Elainezhang0510/Constellate-Braille-Display/hardware/enclosure/v3/使用说明.md

# 六执行器紧凑盒体（树莓派在盒外）

版本 v3（2026-10-16）：仅将两侧上方 39 × 2 mm 长窗缩短、缩窄为居中的 20 × 1.2 mm 散热缝。v2 的下方 39 × 4 mm 长窗、六个 8 mm 朝外套筒开口、盖子、孔位、外形、底板、承台、出线口和材料均保持不变。

全部模型以毫米建模。外形 40 × 56 × 37 mm，六执行器两列三行，中心距 16 mm；树莓派与驱动电路放盒外。

## 文件

- `container_assembly.step`：盒体和盖子的装配实体，可导入 Autodesk Fusion / Inventor。两个独立实体，不含执行器。
- `base.stl`：直接切片打印的盒体，底面已在 Z=0。
- `lid_print.stl`：直接切片打印的盖子，外表面朝下，凹槽朝上，已在 Z=0；此文件方向与装配 STEP 不同。
- `base.step`、`lid_print.step`：对应单件实体。
- `fit_coupon.stl`：省料试配件；左孔为 10.5 mm 壳体孔，右孔为 4.6 mm 头部孔。先打印这个，实物壳体和头部应能顺畅插入。
- `assembly_with_reference.step`：含六个简化执行器外形的检查模型。执行器外形只作参考，不能打印成执行器。
- `preview.png`：模型生成的装配与分解预览。
- `build_container.py`：可修改尺寸的 CadQuery 参数化源文件，需要 Python、cadquery、trimesh、matplotlib。
- `validation.json`：实体与网格检查结果。

Fusion 可直接打开或上传 STEP；导入 STL 时选择毫米。STEP 是可编辑实体，但不包含 Fusion 原生的参数历史。

## 结构与公差

普通壁、底、盖厚均为 2.4 mm。盖子有六个 4.6 mm 通孔（按用户要求兼容 4 mm 头部，直径余量 0.6 mm）；执行器定位孔仍为 10.5 mm（对应图片 10 mm 壳体，直径余量 0.5 mm）。本次加宽的是套筒侧面槽口，宽 8 mm、高 14 mm（Z=13–27 mm），不是扩大执行器定位孔。两列分别朝向最近的外侧长边，槽口小于 10 mm 壳体直径，保留侧向限位，执行器仍从上方插入。

每个长边的下长窗仍为 39 × 4 mm（Y=8.5–47.5 mm，Z=5–9 mm）。上方仅保留一个 20 × 1.2 mm 散热缝，位于 Y=18–38 mm、Z=29.4–30.6 mm，两侧对称。上缝顶端到盒体顶边留 4 mm 实体壁。下长窗两端各保留 8.5 mm 支撑区域，螺钉柱完整保留。底座横向走线窗和短边 8 × 5 mm 出线口不变。散热缝用于自然通风，未验证线圈温升或具体散热能力。

执行器壳体底面安装高度为 Z=13 mm，壳体按 19.5 mm 高设计；下方活动尾轴按 4 mm 静态长度、额外向下移动 5.5 mm、直径不超过 4 mm 预留。尾轴运动包络最低 Z=3.5 mm，距 2.4 mm 底板有 1.1 mm 余量；底板上表面到定位承台下表面为 8.4 mm，可穿引线。尾轴所在孔不可塞入导线。

盖子内面有六个定位凸台和 8.6 mm 直径、2.7 mm 有效深度的颈部沉孔。按照片推定黑色颈部不超过 8.0 mm 直径、2.9 mm 高。颈部直径并未在原图标注，必须用实物核对；超过沉孔尺寸时需修改源文件，不能强行压盖。壳体顶面与盖内定位面有 0.3 mm 轴向间隙；径向间隙可用少量薄耐热胶带或薄垫片消除，勿粘住活动轴。

图片实际标明轴径 2.2 mm，“4 mm”看起来是尾部伸出长度，不是头部直径。本模型保留用户指定的 4 mm 头部通行空间。图片 19.5 + 2.9 + 6.5 = 28.9 mm，与标注总长 28.6 mm 有 0.3 mm 差异；这里按分段尺寸建模。

按图片中的静态位置，头部顶端高于盖顶约 4.9 mm；这不是全行程保证。若从该位置回缩 5.5 mm，头端会低于盖面约 0.6 mm。执行器断电位置、运动方向和尺寸需要实物确认；若希望全行程始终露出，需根据实际行程调整高度，不能仅依据照片保证。

## 低成本打印与装配

选普通 PETG，兼顾常见可得性与比 PLA 更高的耐温能力；不需要碳纤维、树脂或金属打印。线圈实际工作温度未知，PETG 也不能保证适合连续高温通电。

建议 0.4 mm 喷嘴、0.2 mm 层高、3 道墙、4–5 层顶底、15% 填充，按材料厂家提供的 PETG 温度设置。盒体开口朝上，盖子使用 `lid_print.stl` 的现成方向。下长窗顶部仍有 39 mm 跨度，必须设置可移除的局部支撑，避免 PETG 桥接下垂。上散热缝跨度缩短到 20 mm、高度仅 1.2 mm，应检查切片桥接路径；优先先打印同材质桥接试样确认能跨过 20 mm，必要时加可移除局部支撑并确保窄缝能清理干净。套筒内部和盖子无需新增支撑。具体用料和时间以切片器为准。

新版用料估算见 `validation.json` 的 `solid_petg_mass_g`，不含试配件、螺钉和切片支撑。该数字按 CAD 实心体积和 PETG 密度 1.27 g/cm³ 计算，非实际称重。

用 4 颗 ST2.5 × 10 mm 盘头自攻螺钉固定盖子，不需要热熔嵌件或螺母。盖孔 2.9 mm，盒柱底孔 2.1 mm，轻拧至贴合即可，勿过度拧紧。先试配小件，再装入六个执行器；壳体坐在承台上，引线从槽向下穿过走线窗并汇到侧孔，尾轴周围保持空隙，最后盖上盖子并拧螺钉。螺钉头额外增加局部高度，未计入 37 mm 塑料外形高度。

原引线约 15 mm，通常需要焊接延长并热缩绝缘，留少量维修余量。所有焊接接头应避开活动轴、线圈外壳与紧固柱。

执行器不能直接接树莓派 GPIO。盒外使用匹配电压和电流的六路 MOSFET/晶体管驱动及续流保护，线圈独立供电并与树莓派共地。图片给出的额定电压是 7.4 V，不能把图片中的“短时 7–12 V 可工作”当作 12 V 连续工作的额定许可。

## 验证范围

生成脚本检查各打印件为单一有效实体、STL 封闭且面方向一致；检查盒盖无体积干涉、六个假定执行器外形无干涉、尾轴向下 5.5 mm 扫掠包络不碰盒体。新版另对照 v2 STEP 验证盖子几何完全相同，变更仅发生在两侧上方窗口区域，并检查六个套筒开口均朝外且背壁仍在。

这是几何检查，不是有限元承载认证；保留的端部支撑、顶梁和中部墙面用于维持盒体结构连续。未进行实际打印、外力承载或温升测试，无法在未知外部载荷下承诺绝不塌陷。正确生成长窗局部支撑是避免打印过程中窗口顶梁塌落的必要步骤。请先试配件验证实际孔公差和颈部尺寸。

## 参考资料

- Autodesk 支持格式：https://help.autodesk.com/view/fusion360/ENU/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
- PETG 材料说明：https://help.prusa3d.com/article/petg_2059
- 执行器尺寸和电参数来源：用户提供的图片；不是制造商正式图纸。
