Elainezhang0510/Constellate-Braille-Display/hardware/enclosure/v3/preview.png

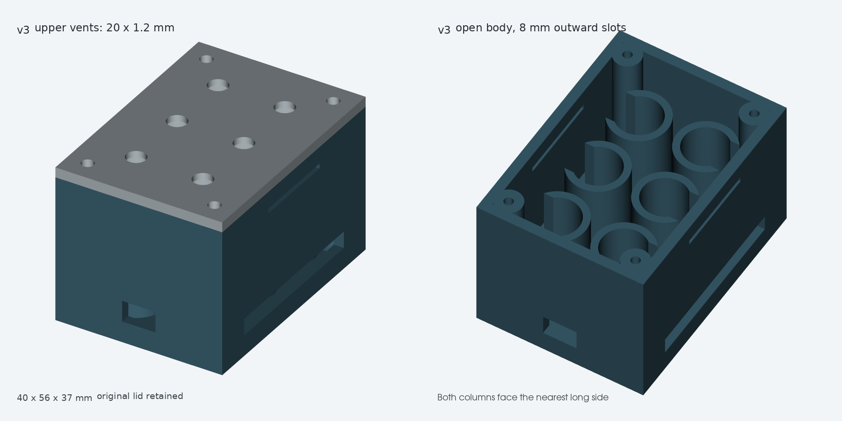
hardware/enclosure/v3/preview.png
