Elainezhang0510/Constellate-Braille-Display/hardware/pcb/电磁线圈.xlsx

描述 | 立创料号 | 位号 | 封装 | 数量
100nF/0603 | C408909 | C1, C2, C3, C4, C5, C6, C13, C14, C15，C17, C20, C21，C19 | C0603 | 13
10uF/25V | C669099 | C7, C10, C11, C12, C16, C18 | C0805 | 6
470uF/16V/ERE1EM471G13OT | C105289 | C9 | EC5X12.5X20V | 1
US1M | C7420317 | D1, D2, D3, D4, D5, D6, D8 | SMA | 7
GL0603UG01 | C51933293 | D7, D10 | D0603 | 2
BAT46WS | C2991954 | D9 | SOD-323 | 1
WAFER-XH2.54-2PZZ (https://item.szlcsc.com/6173867.html?fromZone=s_s__%22XH-2.54-2P%22) | C5359631 | J1, J2, J3, J4, J5, J6, J7,J8 | XH-2.54-2P | 8
Header 20*2 | Header, 18-Pin, Dual row | P1 | HDR2X20 | 1
NCE6020AK | C108639 | Q1, Q2, Q3, Q4, Q5, Q6 | TO-252 | 6
10K/0603 | C2906982 | R3, R4, R8, R9, R10, R13, R14, R18, R19, R20, R24, R25, R26, R27, R28, R29, R30, R31 | R0603 | 18
100R/0603 | C22775 | R5, R6, R7, R15, R16, R17 | R0603 | 6
1K/0603 | C2907002 | R11, R12, R21, R22,R1, R2, R23, R32 | R0603 | 8
TS-1101-C-W | C318938 | SW1, SW2, SW3, SW4, SW5, SW6 | TS-1101-C-W | 6
TC4427AEOA713 | C20551 | U1, U2, U3 | SOIC-8 | 3
AMS1117 | C22461603 | U4 | SOT-223 | 1
