Elainezhang0510/Constellate-Braille-Display/hardware/enclosure/v3/container_assembly.step

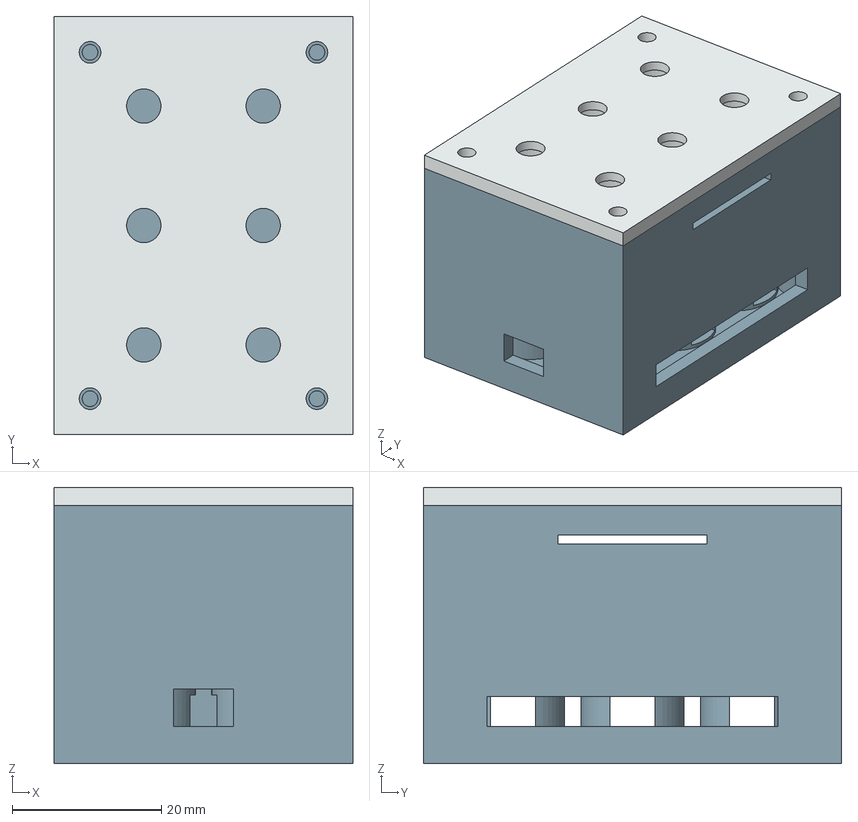
[picture p2: CAD file, 2026-11-01]
hardware/enclosure/v3/container_assembly.step
40.0 x 56.0 x 37.0 mm
base
lid
