Elainezhang0510/Constellate-Braille-Display/hardware/enclosure/v3/assembly_with_reference.step

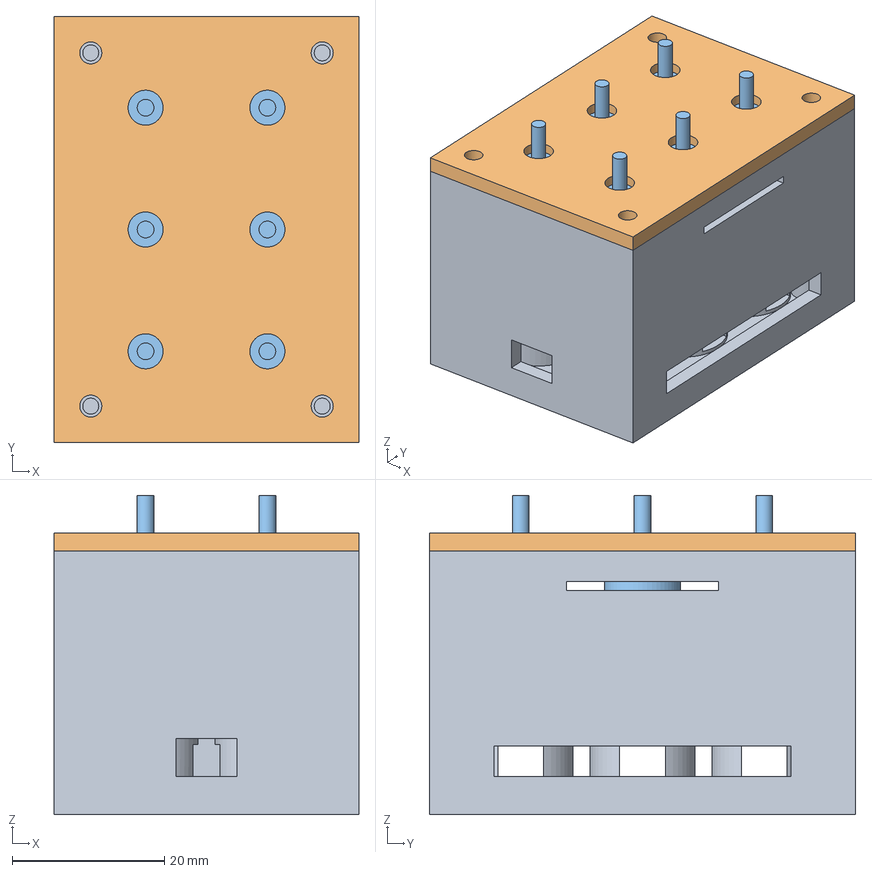
[picture p3: CAD file, 2026-11-01]
hardware/enclosure/v3/assembly_with_reference.step
40.0 x 56.0 x 41.9 mm
base
lid
actuator_envelope_1
actuator_envelope_2
actuator_envelope_3
actuator_envelope_4
actuator_envelope_5
actuator_envelope_6
