Elainezhang0510/Constellate-Braille-Display/hardware/enclosure/v3/lid_print.step

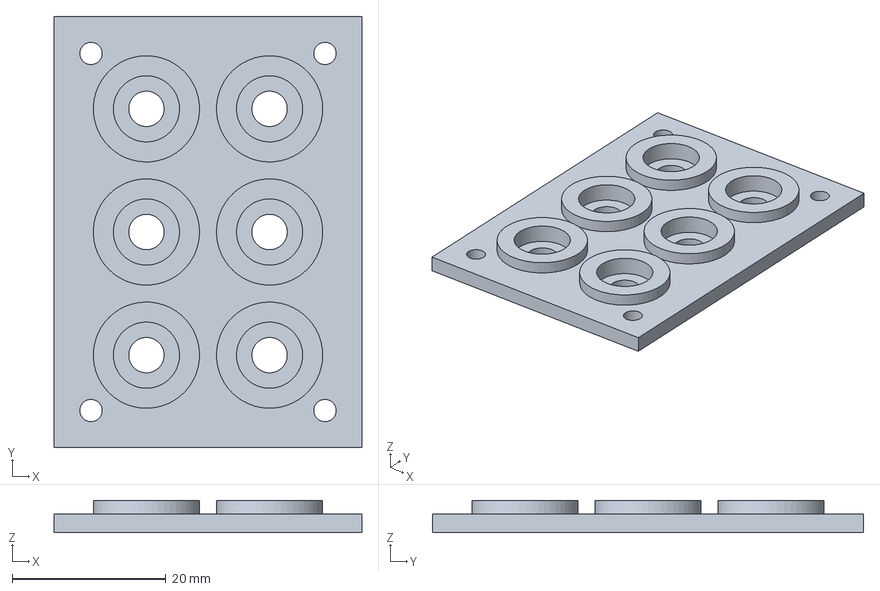
[picture p4: CAD file, 2026-11-01]
hardware/enclosure/v3/lid_print.step
40.0 x 56.0 x 4.20 mm
