Elainezhang0510/Constellate-Braille-Display/hardware/enclosure/v3/base.step

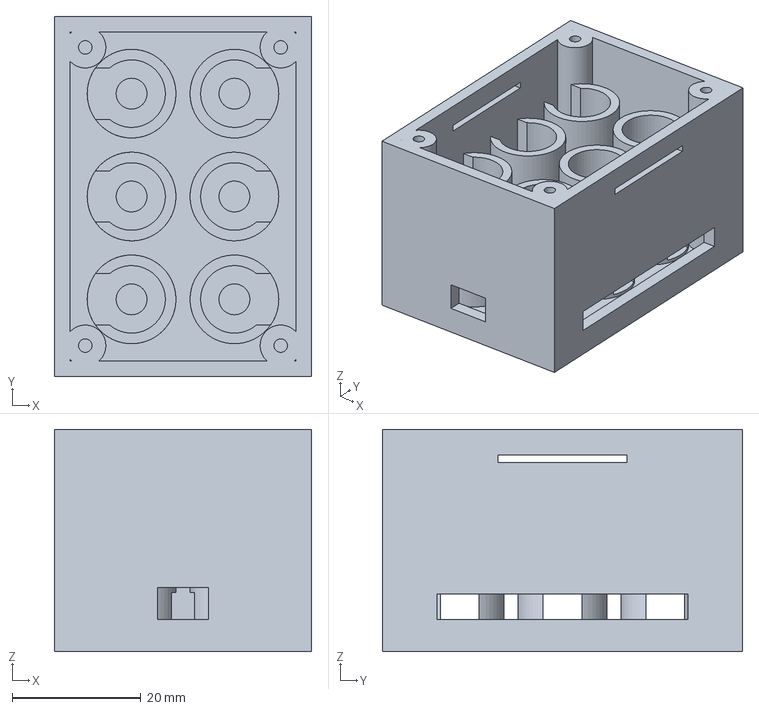
[picture p5: CAD file, 2026-11-01]
hardware/enclosure/v3/base.step
40.0 x 56.0 x 34.6 mm
