Elainezhang0510/Constellate-Braille-Display/hardware/enclosure/v3/fit_coupon.step

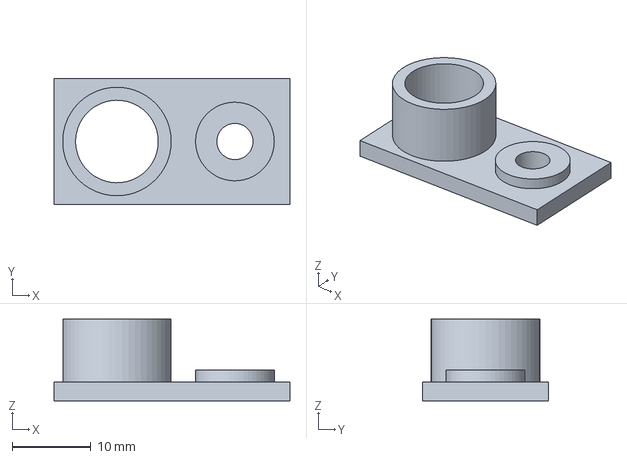
[picture p6: CAD file, 2026-11-01]
hardware/enclosure/v3/fit_coupon.step
30.0 x 16.0 x 10.4 mm
