Elainezhang0510/Constellate-Braille-Display/(list of files, cad)

Other CAD files:
hardware/enclosure/v3/base.stl
hardware/enclosure/v3/fit_coupon.stl
hardware/enclosure/v3/lid_print.stl
