Elainezhang0510/Constellate-Braille-Display/hardware/pcb/raspberry-pi-wiring.png

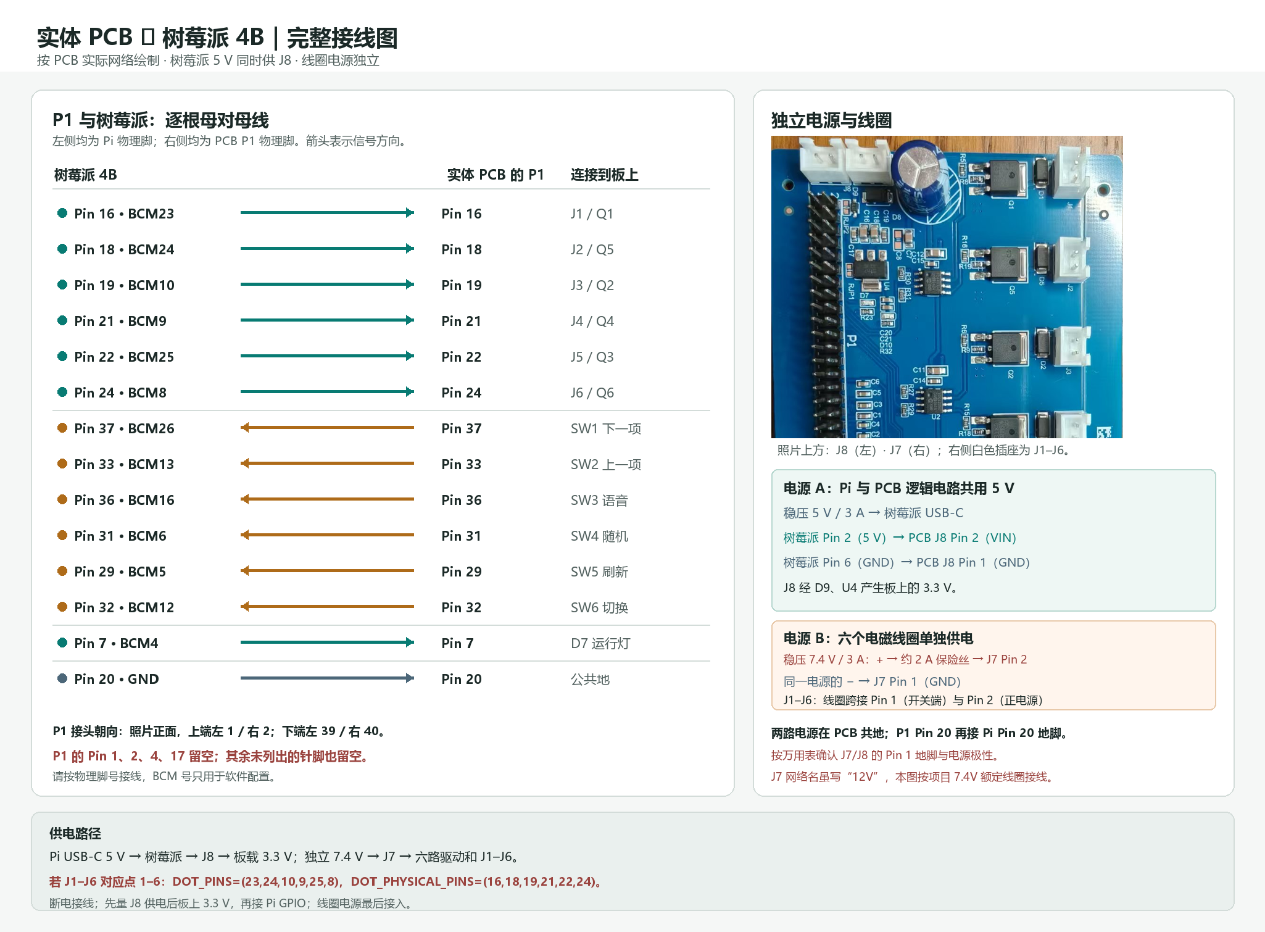
hardware/pcb/raspberry-pi-wiring.png
