Elainezhang0510/Constellate-Braille-Display/hardware/pcb/电磁线圈.pdf

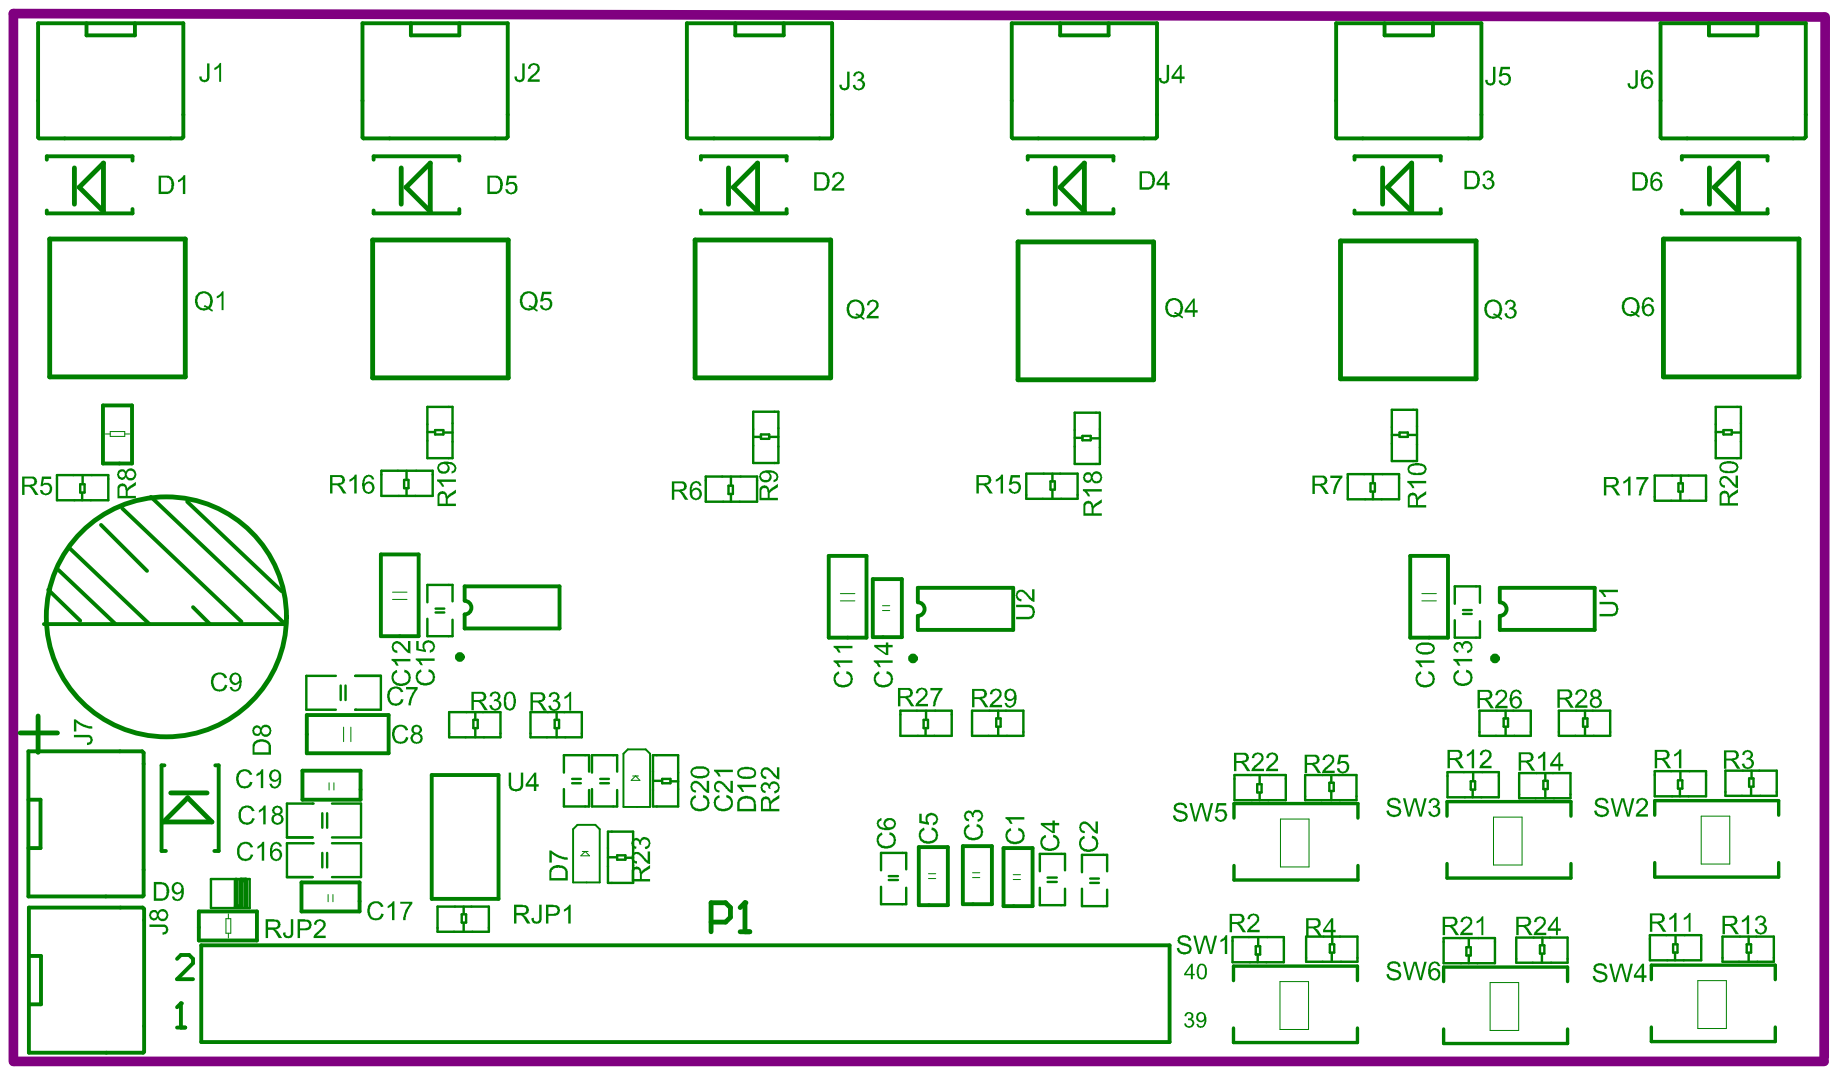
[picture p8: page 1]
