Elainezhang0510/Constellate-Braille-Display/(list of files, drawings)

Other design files:
hardware/pcb/电磁线圈.PcbDoc
hardware/pcb/电磁线圈.SchDoc
