Elainezhang0510/Constellate-Braille-Display/raspberry-pi/reference/refreshable_braille_display.ino

/*

The objective of this program is to take a string and represent it
using the braille display one letter at a time.

The braille alphabet uses characters with six dots
in three rows and two columns. the dots are labeled 1-6
as follows:

  1  4
  2  5
  3  6

*/

// store the code for each letter a-z in a 2D array
int braille[26][6] = {
  {1,0,0,0,0,0},  // a (first bump is raised, others are lowered)
  {1,1,0,0,0,0},  // b (first and second bumps are raised)
  {1,0,0,1,0,0},  // c (and so on...)
  {1,0,0,1,1,0},  // d
  {1,0,0,0,1,0},  // e
  {1,1,0,1,0,0},  // f
  {1,1,0,1,1,0},  // g
  {1,1,0,0,1,0},  // h
  {0,1,0,1,0,0},  // i
  {0,1,0,1,1,0},  // j
  {1,0,1,0,0,0},  // k
  {1,1,1,0,0,0},  // l
  {1,0,1,1,0,0},  // m
  {1,0,1,1,1,0},  // n
  {1,0,1,0,1,0},  // o
  {1,1,1,1,0,0},  // p
  {1,1,1,1,1,0},  // q
  {1,1,1,0,1,0},  // r
  {0,1,1,1,0,0},  // s
  {0,1,1,1,1,0},  // t
  {1,0,1,0,0,1},  // u
  {1,1,1,0,0,1},  // v
  {0,1,0,1,1,1},  // w
  {1,0,1,1,0,1},  // x
  {1,0,1,1,1,1},  // y
  {1,0,1,0,1,1},  // z
};

// array of the Arduino pins used to control the solenoids
int controlPins[6] = {2,3,4,5,6,7};

// pin for the button
int buttonPin = 8;

// array for the alphabet
char alphabet[] = "abcdefghijklmnopqrstuvwxyz";

// string to convert to braille
String text = "hello";

// variable for getting the individual letter of the text[] array
char letter;

// variable for finding the index of letter in alphabet
int index;

// length of the text[] array (I this adds one because of the weird zero padding thing?)
int length = text.length();

void setup(){ // setup code that only runs once
  // initialize serial communication (allows printing to serial monitor)
  Serial.begin(9600);
  // set control pins as outputs
  for(int i=0; i<=5; i++){
    pinMode(controlPins[i],OUTPUT);
  }
  // set button pin as input
  pinMode(buttonPin,INPUT);
  
}

void loop(){  // code that loops forever
  
  // loop through each letter of text input
  for(int i=0; i<length; i++){
    letter = text[i]; // get i'th letter of text
    // find index of this letter in the alphabet
    for(int j = 0; j<=26; j++){
      if(letter == alphabet[j]){
        index = j;
      }
    } 
    // print the letter and its index to make sure this is correct
    Serial.print(letter);
    Serial.print(" ");
    Serial.println(index);
    
    // get the corresponding row [index] from the braille array 
    // and iterate through the columns [k] to set the corresponding pins
    for(int k = 0; k<=5; k++){
      digitalWrite(controlPins[k],braille[index][k]); 
    }
    // wait for button press before showing the next letter
    while(digitalRead(buttonPin) == LOW){};
    delay(1000);
  } 
}
